georges-circuits/coincell_flashlight/Core/Inc/main.h

#define LEDW_Pin GPIO_PIN_0
#define LEDW_GPIO_Port GPIOF
#define BUTTON_IRQ_Pin GPIO_PIN_0
#define BUTTON_IRQ_GPIO_Port GPIOA
#define BUTTON_IRQ_EXTI_IRQn EXTI0_1_IRQn
#define SHAKE_Pin GPIO_PIN_2
#define SHAKE_GPIO_Port GPIOA
#define BUTTON_Pin GPIO_PIN_3
#define BUTTON_GPIO_Port GPIOA
#define LED5_Pin GPIO_PIN_4
#define LED5_GPIO_Port GPIOA
#define LED0_Pin GPIO_PIN_6
#define LED0_GPIO_Port GPIOA
#define LED1_Pin GPIO_PIN_7
#define LED1_GPIO_Port GPIOA
#define LED2_Pin GPIO_PIN_1
#define LED2_GPIO_Port GPIOB
#define LED4_Pin GPIO_PIN_9
#define LED4_GPIO_Port GPIOA
#define LED3_Pin GPIO_PIN_10
#define LED3_GPIO_Port GPIOA
