georges-circuits/coincell_flashlight/main/inc/flashlight_main.h

/*
 *  flashlight_main.h
 *
 *  Created on: 5 Dec 2019
 *  Author: Jiri Manak
 */

#ifndef __flashlight_main_h__
#define __flashlight_main_h__

#include "stm32f0xx_hal.h"


void display_error(uint8_t pulses);

#endif 
