georges-circuits/coincell_flashlight/(commit log)

2019-12-05 screwed readme
2019-12-06 Now it actually compiles without problems, the libs were incorrectely imported or I screwed up configuring the cube
    [flashlight_main.c, flashlight_main.h, main.h]
2019-12-06 the gamma corrected PWM kinda works
    [coincell_flashlight.ioc, flashlight_main.c, main.h]
2019-12-11 seems to work pretty well now, going to measure the current and tst the battery
2019-12-12 switched to Button IRQ because I figured it would wake up too often, implementing ADC features
2019-12-12 loaded this onto another board, testing with battery, seems to work great
2019-12-18 tweaked some things, flashed onto all the boards, I'll have 9 in total to give away
